AbdElelah2000/Lidar-3D-room-mapper/README.md

# Lidar-3D-room-mapper
The project mainly revolves around a micro-controller (MSP-EXP432E401Y), a stepper motor and a lidar sensor, which uses different programs in C, Assembly and Python for data acquisition and 3d modelling the data on the computer (open3D Python library).
- Please refer to the Keil and Program branches for the code part of the project
